vihoa/VIDGA-curtain-opener/docs/bom.md

# Bill of materials

Prices are rough German shop prices (2026) and change often. Shops are examples, not endorsements.

## Mechanics

| Part | Spec | Qty | Example source |
|---|---|---|---|
| Worm-gear motor | N20 size, **double output shaft**, **3 V**, 40–60 rpm (lower rpm = more force) | 1 | eBay.de / AliExpress, search "N20 Schneckengetriebemotor Doppelwelle 3V" |
| Wheels | Rubber, Ø34 mm, 3 mm D-hole for N20 | 2 | roboter-bausatz.de "4x Rad mit Gummi Reifen für N20 Motor D Welle" |
| Wheeled gliders | Must fit the 13 mm VIDGA channel (see [rail measurements](#rail-measurements)) | 2 | IKEA / curtain-hardware shops |
| Extension springs | "Zugfeder mit Ösen", wire 0.4–0.5 mm, Ø4–5 mm, 14–15 mm long | 2 | Gutekunst Federn, hardware-store assortment |
| LEGO parts | See [`cad/README.md`](../cad/README.md) | – | Own collection, BrickLink, LEGO Pick a Brick |
| Zip ties | 2.5 × 100 mm | ~15 | – |
| Double-sided foam tape | ~1 mm | – | – |

## Electronics

| Part | Spec | Qty | Example source |
|---|---|---|---|
| Calliope mini 1.3 | Carriage controller | 1 | – |
| Calliope mini (any) or micro:bit | Remote (optional) | 1 | – |
| Battery holder | 2×AAA with JST-PH plug for Calliope | 1 (+1 remote) | BerryBase, technik-lpe.de |
| Batteries | **NiMH** AAA, low self-discharge (e.g. Eneloop) – never alkaline | 2 (+2) | – |
| Wires to motor pins | Jumper wires or 2.54 mm pin header | – | – |

## Charging dock

| Part | Spec | Qty | Example source |
|---|---|---|---|
| Magnetic pogo connector | **2-pin**, 2 A, plug + socket | 1 pair | BerryBase art. 157030 |
| Schottky diode | 1N5819 (1N5817 / SB140 also fine) | 1 | Reichelt, Conrad |
| Resistor | 33 Ω, ≥0.25 W | 1 | BerryBase, Reichelt |
| Resistors | 10 kΩ, 0.25 W | 2 | BerryBase, Reichelt |
| Heat-shrink tube | Assortment, 2–8 mm | – | – |
| USB charger + cable | 5 V, ≥1 A; cut the cable (red = +5 V, black = GND) | 1 | – |
| Dock clamp | M3 × 45 screw, M3 nut, body washer DIN 9021 (Ø ≥8 mm, ≤12.5 mm) | 1 each | Hardware store |
| LEGO round brick 2×2 with axle hole | 3941 | 4 | – |

## Rail measurements

Measured on a 3-track IKEA VIDGA rail (mm):

| | Value |
|---|---|
| Channel inner width | 13 |
| Channel inner height | 12 |
| Slot width | 7 |
| Lip thickness | 1 |
| Flat underside beside the front slot | 3 |
| Rail height | 22 |
| Rail width (3-track) | 42 |
| Channel pitch | 13.75 |
