vihoa/VIDGA-curtain-opener/cad/printed-frame/frame.stl

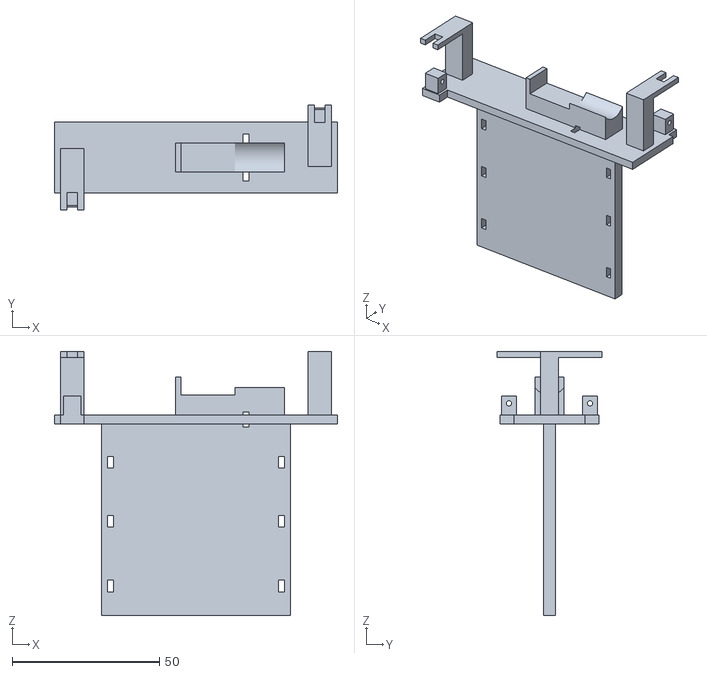
[picture p2: CAD file, 2026-10-29]
cad/printed-frame/frame.stl
96.0 x 35.5 x 89.6
